maheen-ahmed1/27mhz-analog-walkie-talkie/BOM.csv

Order | Ref | Qty_per_unit | Qty_2_units | Design_Value | Part_To_Buy | Store | Unit_Price_BDT | Line_Total_BDT | Stock_checked_2026-09-21 | Link | Note
A | Q1,Q2 | 2 | 10 | BC547 | BC547 NPN Transistor | TechShopBD | 5.04 | 50.40 | In stock | https://techshopbd.com/product/bc547-npn-transistor | 4 needed; buy 10 - test every one (fakes will not oscillate at 27 MHz) and 1 for the crystal test jig
A | U1 | 1 | 2 | LM386 | LM386 OPAMP | TechShopBD | 20.05 | 40.10 | In stock | https://techshopbd.com/product/lm386-opamp | Also RobotechShop at same price
A | MK1 | 1 | 2 | Electret | Electret Microphone | TechShopBD | 20.04 | 40.08 | In stock | https://techshopbd.com/product/electret-microphone | Twist the lead pair (BUILD.md sec.6.6)
A | R1,R5 | 2 | 4 | 33k | 33K Ohm 1/4W Resistor Pack of 20 | TechShopBD | 10.04 | 10.04 | In stock | https://techshopbd.com/product/33k-ohm-14w-resistor-pack-of-20-1 | Slug without -1 is 3.3K - wrong part. Pack also supplies quench R1/R2 and test-jig bias
A | R2,R6 | 2 | 4 | 15k | 15K Ohm 1/4W Resistor Pack of 20 | TechShopBD | 10.04 | 10.04 | In stock | https://techshopbd.com/product/15k-ohm-14w-resistor-pack-of-20-1 | Slug without -1 is 1.5K - wrong part. Pack also supplies test-jig bias
A | R3,R7 | 2 | 4 | 56R | 56 Ohm 1/4W Resistor Pack of 20 | TechShopBD | 9.99 | 9.99 | In stock | https://techshopbd.com/product/56-ohm-14w-resistor-pack-of-20 | 56R IS CORRECT - never lower it (below ~30R the TX stops; on RX it does nothing)
A | R4,R8 | 2 | 4 | 390R | 390 Ohm 1/4W Resistor Pack of 20 | TechShopBD | 10.39 | 10.39 | In stock | https://techshopbd.com/product/390-ohm-14w-resistor-pack-of-20
A | R9 | 1 | 2 | 10k | 10K Ohm 1/4W Resistor Pack of 20 | TechShopBD | 10.04 | 10.04 | In stock | https://techshopbd.com/product/10k-ohm-14w-resistor-pack-of-20 | Sets 3.4 kHz quench filter with C11
A | R10 | 1 | 2 | 4k7 | 4.7K Ohm 1/4W Resistor Pack of 20 | TechShopBD | 15.07 | 15.07 | In stock | https://techshopbd.com/product/47k-ohm-14w-resistor-pack-of-20 | Electret bias
A | R11 | 1 | 2 | 10R | 10 Ohm 1/4W Resistor Pack of 20 | TechShopBD | 10.30 | 10.30 | In stock | https://techshopbd.com/product/10-ohm-14w-resistor-pack-of-20 | LM386 Zobel with C18
A | C5,C10 | 2 | 4 | 15p | Ceramic Capacitor 15pF 150 | TechShopBD | 1.09 | 4.36 | In stock | https://techshopbd.com/product/ceramic-capacitor-150-15pf | EXACT VALUE - do not substitute
A | C2,C7 + jig | 2 | 6 | 33p | Ceramic Capacitor 30pF 300 (SUBSTITUTE) | TechShopBD | 1.99 | 11.94 | In stock | https://techshopbd.com/product/ceramic-capacitor-300-30pf | 4 for C2/C7 + 2 for the crystal test jig. C2 is CRITICAL: measure and select - err LOW never high (+30% kills the TX)
A | C3,C8 + jig | 2 | 5 | 82p | Ceramic Capacitor 100pF 101 (SUBSTITUTE) | TechShopBD | 1.50 | 7.50 | In stock | https://techshopbd.com/product/ceramic-capacitor-101-100pf | 4 for C3/C8 + 1 test-jig output cap. 30p/100p substitute build VERIFIED in LTspice - slightly stronger than 33p/82p
A | C4,C9 + quench | 2 | 6 | 10n | Ceramic Capacitor 10nF 103 | TechShopBD | 1.50 | 9.00 | In stock | https://techshopbd.com/product/ceramic-capacitor-103-10nf | 4 emitter bypass (sit physically at the emitter) + 2 for 555 pin 5
A | C1,C6,C18 | 3 | 7 | 39n/47n | BUY 33nF (marked 333) - replaces BOTH the 39nF and the 47nF, which are not stocked | TechShopBD | 1.20 | 8.40 | In stock | https://techshopbd.com/product/ceramic-capacitor-333-33nf | C6 (RX) must stay 22-39nF: 33n gives 1.44x response vs 1.06x at 47n and deaf at 100n (sim, with quench). C1 (TX) and C18 (Zobel) are not sensitive
A | C11 | 1 | 2 | 4n7 | 0.0047uF 100V Capacitor | TechShopBD | 2.50 | 5.00 | In stock | https://techshopbd.com/product/00047uf-100v-capacitor | EXACT VALUE - sets quench low-pass
A | C19 | 1 | 2 | 100n | Ceramic Capacitor 100nF 104 | TechShopBD | 1.50 | 3.00 | In stock | https://techshopbd.com/product/ceramic-capacitor-104-100nf | Supply decoupling
A | C12,C13 | 2 | 4 | 0.47u/1u | 1uF 50V Capacitor | TechShopBD | 1.54 | 6.16 | In stock | https://techshopbd.com/product/1uf-50v-capacitor | 0.47u is out of stock; 1u for C12 improves HPF 34Hz to 16Hz
A | C14,C15 | 2 | 4 | 10u | 10uF 25V Capacitor | TechShopBD | 2.50 | 10.00 | In stock | https://techshopbd.com/product/10uf-25v-capacitor | Measure - market electrolytics run under value
A | C16,C20 | 2 | 4 | 100u | 100uF 16V Capacitor | TechShopBD | 3.02 | 12.08 | In stock | https://techshopbd.com/product/100uf-16v-capacitor | Supply reservoir
A | C17 | 1 | 2 | 220u | 220uF 16V Capacitor | TechShopBD | 5.02 | 10.04 | In stock | https://techshopbd.com/product/220uf-16v-capacitor | Speaker output coupling
A | RV1 | 1 | 2 | 10k log | 10k Potentiometer | TechShopBD | 20.05 | 40.10 | In stock | https://techshopbd.com/product/10k-potentiometer | Linear taper - acceptable for volume
A | SW1 | 1 | 2 | Power SPST | SPDT Slide Switch 0.34in | TechShopBD | 5.03 | 10.06 | In stock | https://techshopbd.com/product/spdt-slide-switch-034in | Use one throw as SPST
A | BT1 | 1 | 2 | 9V | 9V Battery | TechShopBD | 65.04 | 130.08 | In stock | https://techshopbd.com/product/9v-battery
A | BT1 | 1 | 2 | 9V clip | 9V Battery Connector | TechShopBD | 10.04 | 20.08 | In stock | https://techshopbd.com/product/9v-battery-connector | Buy a spare
A | - | 1 | 2 | Board | Veroboard Single Sided Line Type 14.5 x 6.5 cm | TechShopBD | 35.04 | 70.08 | In stock | https://techshopbd.com/product/veroboard-single-sided-line-type | LINE type (strips) not DOT type
A | QUENCH D1 | 1 | 2 | 1N4148 | Diode 1N4148 | TechShopBD | 1.50 | 3.00 | In stock | https://techshopbd.com/product/diode-1n4148 | QUENCH MOD - across 555 R2 to force 50% duty. REQUIRED: 67% duty is deaf (1.04x vs 1.90x response)
A | QUENCH C1 | 1 | 2 | 680p | Ceramic Capacitor 560pF 561 | TechShopBD | 1.09 | 2.18 | In stock | https://techshopbd.com/product/ceramic-capacitor-561-560pf | QUENCH MOD - 680p is OUT OF STOCK; fit 560p in PARALLEL with 120p = 680p = 32 kHz (verified value). 560p alone = 39 kHz
A | QUENCH C1 | 1 | 2 | 680p | Ceramic Capacitor 120pF 121 | TechShopBD | 1.00 | 2.00 | In stock | https://techshopbd.com/product/ceramic-capacitor-121-120pf | QUENCH MOD - parallel with the 560p above
A | QUENCH C1 alt | 1 | 2 | 470p | Ceramic Capacitor 471 470pF | TechShopBD | 1.09 | 2.18 | In stock | https://techshopbd.com/product/ceramic-capacitor-471-470pf | QUENCH MOD - bench-tuning option: 46 kHz
A | QUENCH C1 alt | 1 | 2 | 1n | Ceramic Capacitor 102 1000pF | TechShopBD | 2.04 | 4.08 | In stock | https://techshopbd.com/product/ceramic-capacitor-102-1000pf | QUENCH MOD - bench-tuning option: 22 kHz (looked weakest in sim)
A | JIG Re | 1 | 1 | 1k | 1K Ohm 1/4W Resistor Pack of 20 | TechShopBD | 10.04 | 10.04 | In stock | https://techshopbd.com/product/1k-ohm-14w-resistor-pack-of-20 | CRYSTAL TEST JIG emitter resistor (BUILD.md sec.6.2)
B | CV1 | 1 | 4 | 5-30p | Adjustable RF Trimmer Capacitor - choose 40pF | RobotechShop | 20.00 | 80.00 | In stock (40pF variant) | https://robotechshop.com/shop/components/capacitors/adjustable-trimmer-capacitor-variable-ceramic-capacitor-pcb-mount-for-rf-tuning/ | The 4-27pF trimmer (Tk10) went OUT OF STOCK. 40pF covers the 12-30pF netting range; 20pF variant only reaches mid-range. 2 + 2 spare
B | QUENCH U | 1 | 2 | NE555 | Timer IC 555 | RobotechShop | 15.00 | 30.00 | In stock | https://robotechshop.com/shop/components/general-ics/timer-ic-555/ | QUENCH MOD - QUENCH_MOD.md
B | sockets | 2 | 4 | DIP-8 | IC Base Socket - choose 14 Pin | RobotechShop | 8.00 | 32.00 | In stock (14-pin variant) | https://robotechshop.com/shop/components/ic-base-sockets-dip-sockets/ | 8-pin variant is OUT OF STOCK - cut 14-pin down to 8 with side cutters. For LM386 x2 and NE555 x2
D | Y1 | 1 | 2 | 27 MHz | 27 MHZ Crystal (Model# 3067) | Electronics.com.bd | 18.00 | 36.00 | In stock | https://electronics.com.bd/27-mhz-crystal-oscillators | 2-PIN passive crystal (CL 20pF +/-20ppm) - check pin count on arrival. Buy both in ONE order. 27.145 MHz version is stock out. Confirm fundamental (not 9 MHz overtone) with the test jig
C | SW2,SW3 | 1 | 2 | 4PDT PTT | 4PDT momentary push-to-talk switch | Nawabpur / Stadium Market | 75 | 150 | Not online |  | Nothing online is 4PDT momentary
C | LS1 | 1 | 2 | 8R | 8 Ohm 0.5-1W speaker 50-57mm | Nawabpur / Stadium Market | 45 | 90 | Not online |  | Both TechShopBD speakers OOS; RobotechShop has only 32R and 4R
C | ANT1 | 1 | 2 | Whip | Telescopic whip antenna ~1m | Nawabpur / Stadium Market | 150 | 300 | Not online |  | Range-test on 2.76m wire first (BUILD.md sec.6.9)
C | L1,L2 | - | - | 9T/2T | 0.5mm enamelled copper wire | Nawabpur / Stadium Market | 75 | 75 | Not online |  | TARGETS: L1 = 1.05-1.10 uH L2 = 1.14 uH (different on purpose). Wind one turn long and spread - adjusting turns recovers 87% from a 30% cap error
