maheen-ahmed1/27mhz-analog-walkie-talkie/out/wt27_BLOCKS.pdf

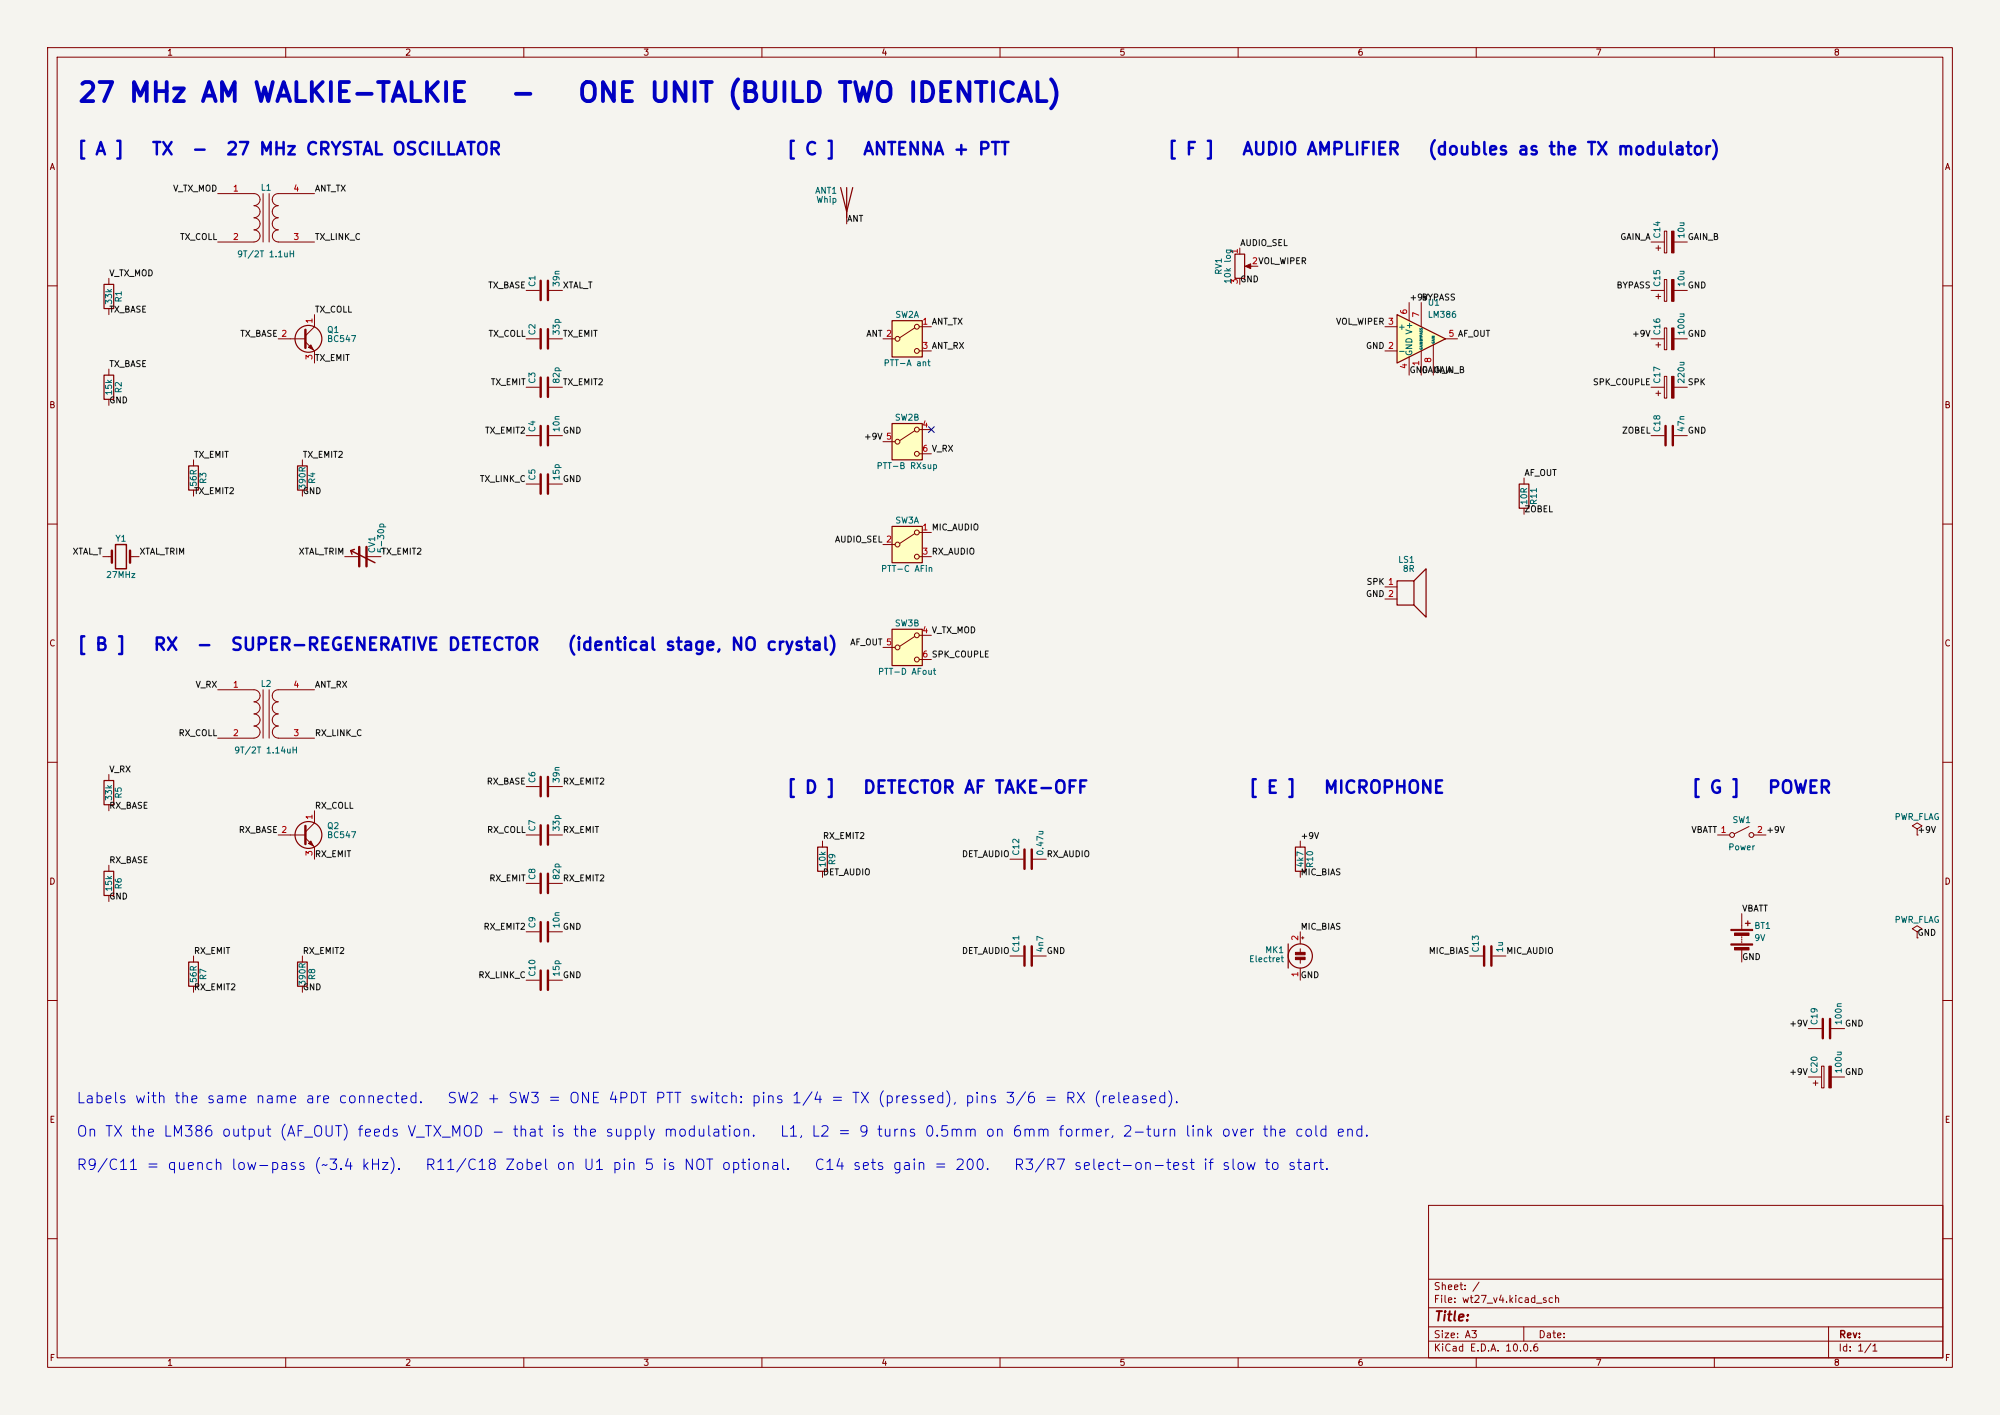
[picture p5: page 1]

Size: A3 | Rev: | F Date:
KiCad E.D.A. 10.0.6 | Id: 1/1
