maheen-ahmed1/27mhz-analog-walkie-talkie/out/wt27_WIRED.pdf

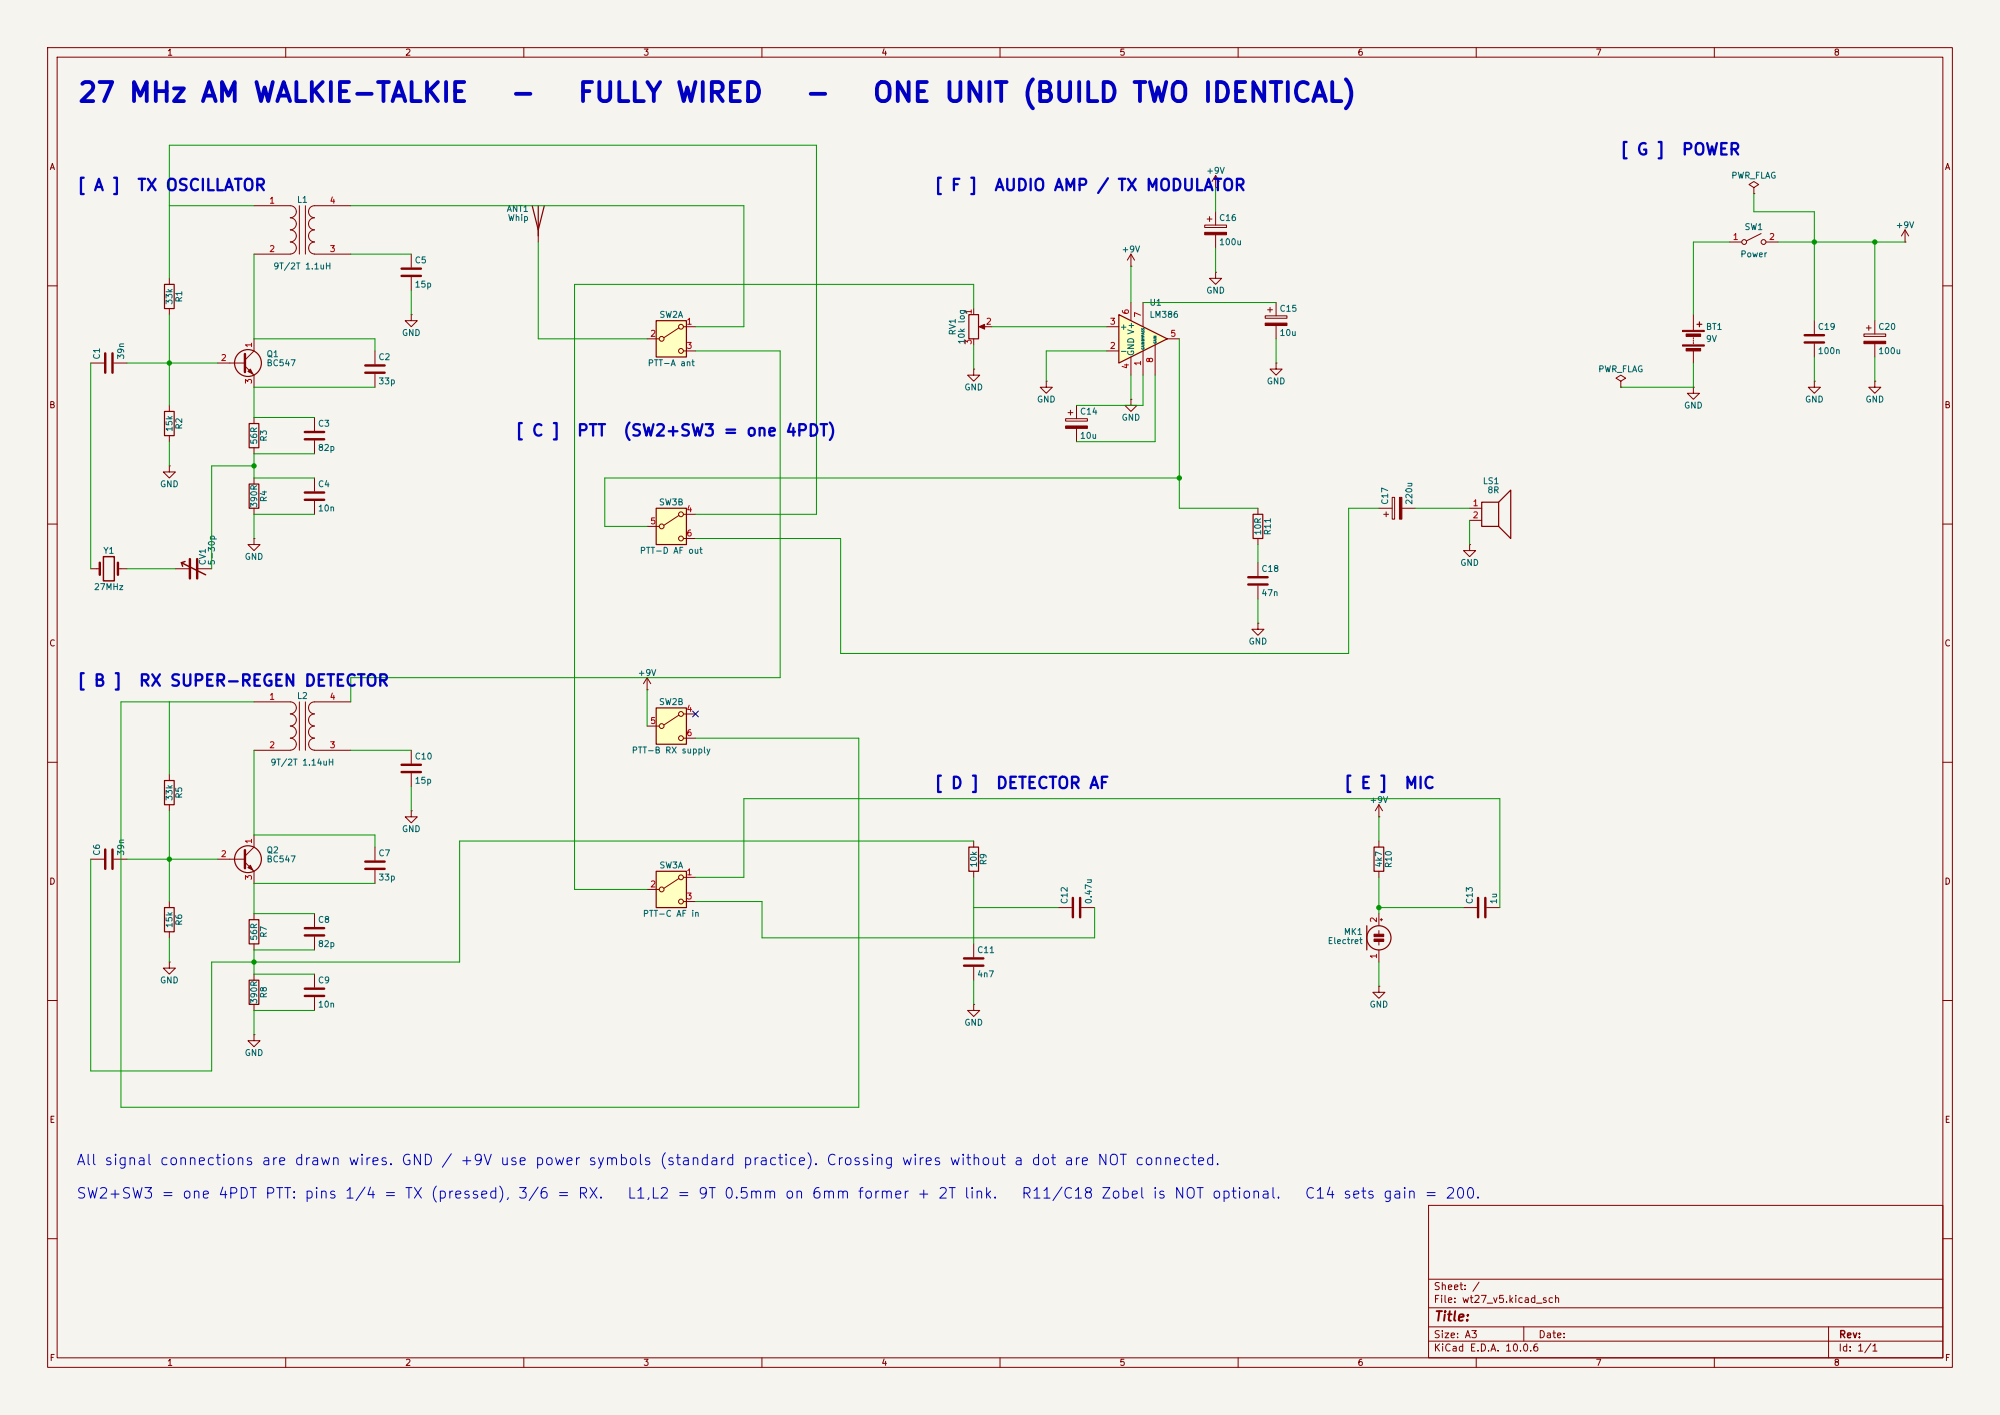
[picture p6: page 1]

[ F ] AUDIO AMP / TX MODULATOR

[ B ] RX SUPER-REGEN DETECTOR

All signal connections are drawn wires. GND / +9V use power symbols (standard practice). Crossing wires without a dot are NOT connected.

Size: A3 | Rev: | F Date:
KiCad E.D.A. 10.0.6 | Id: 1/1
