maheen-ahmed1/27mhz-analog-walkie-talkie/wt27_v5.kicad_sch

## KiCad design wt27_v5.kicad_sch (2026-10-22)

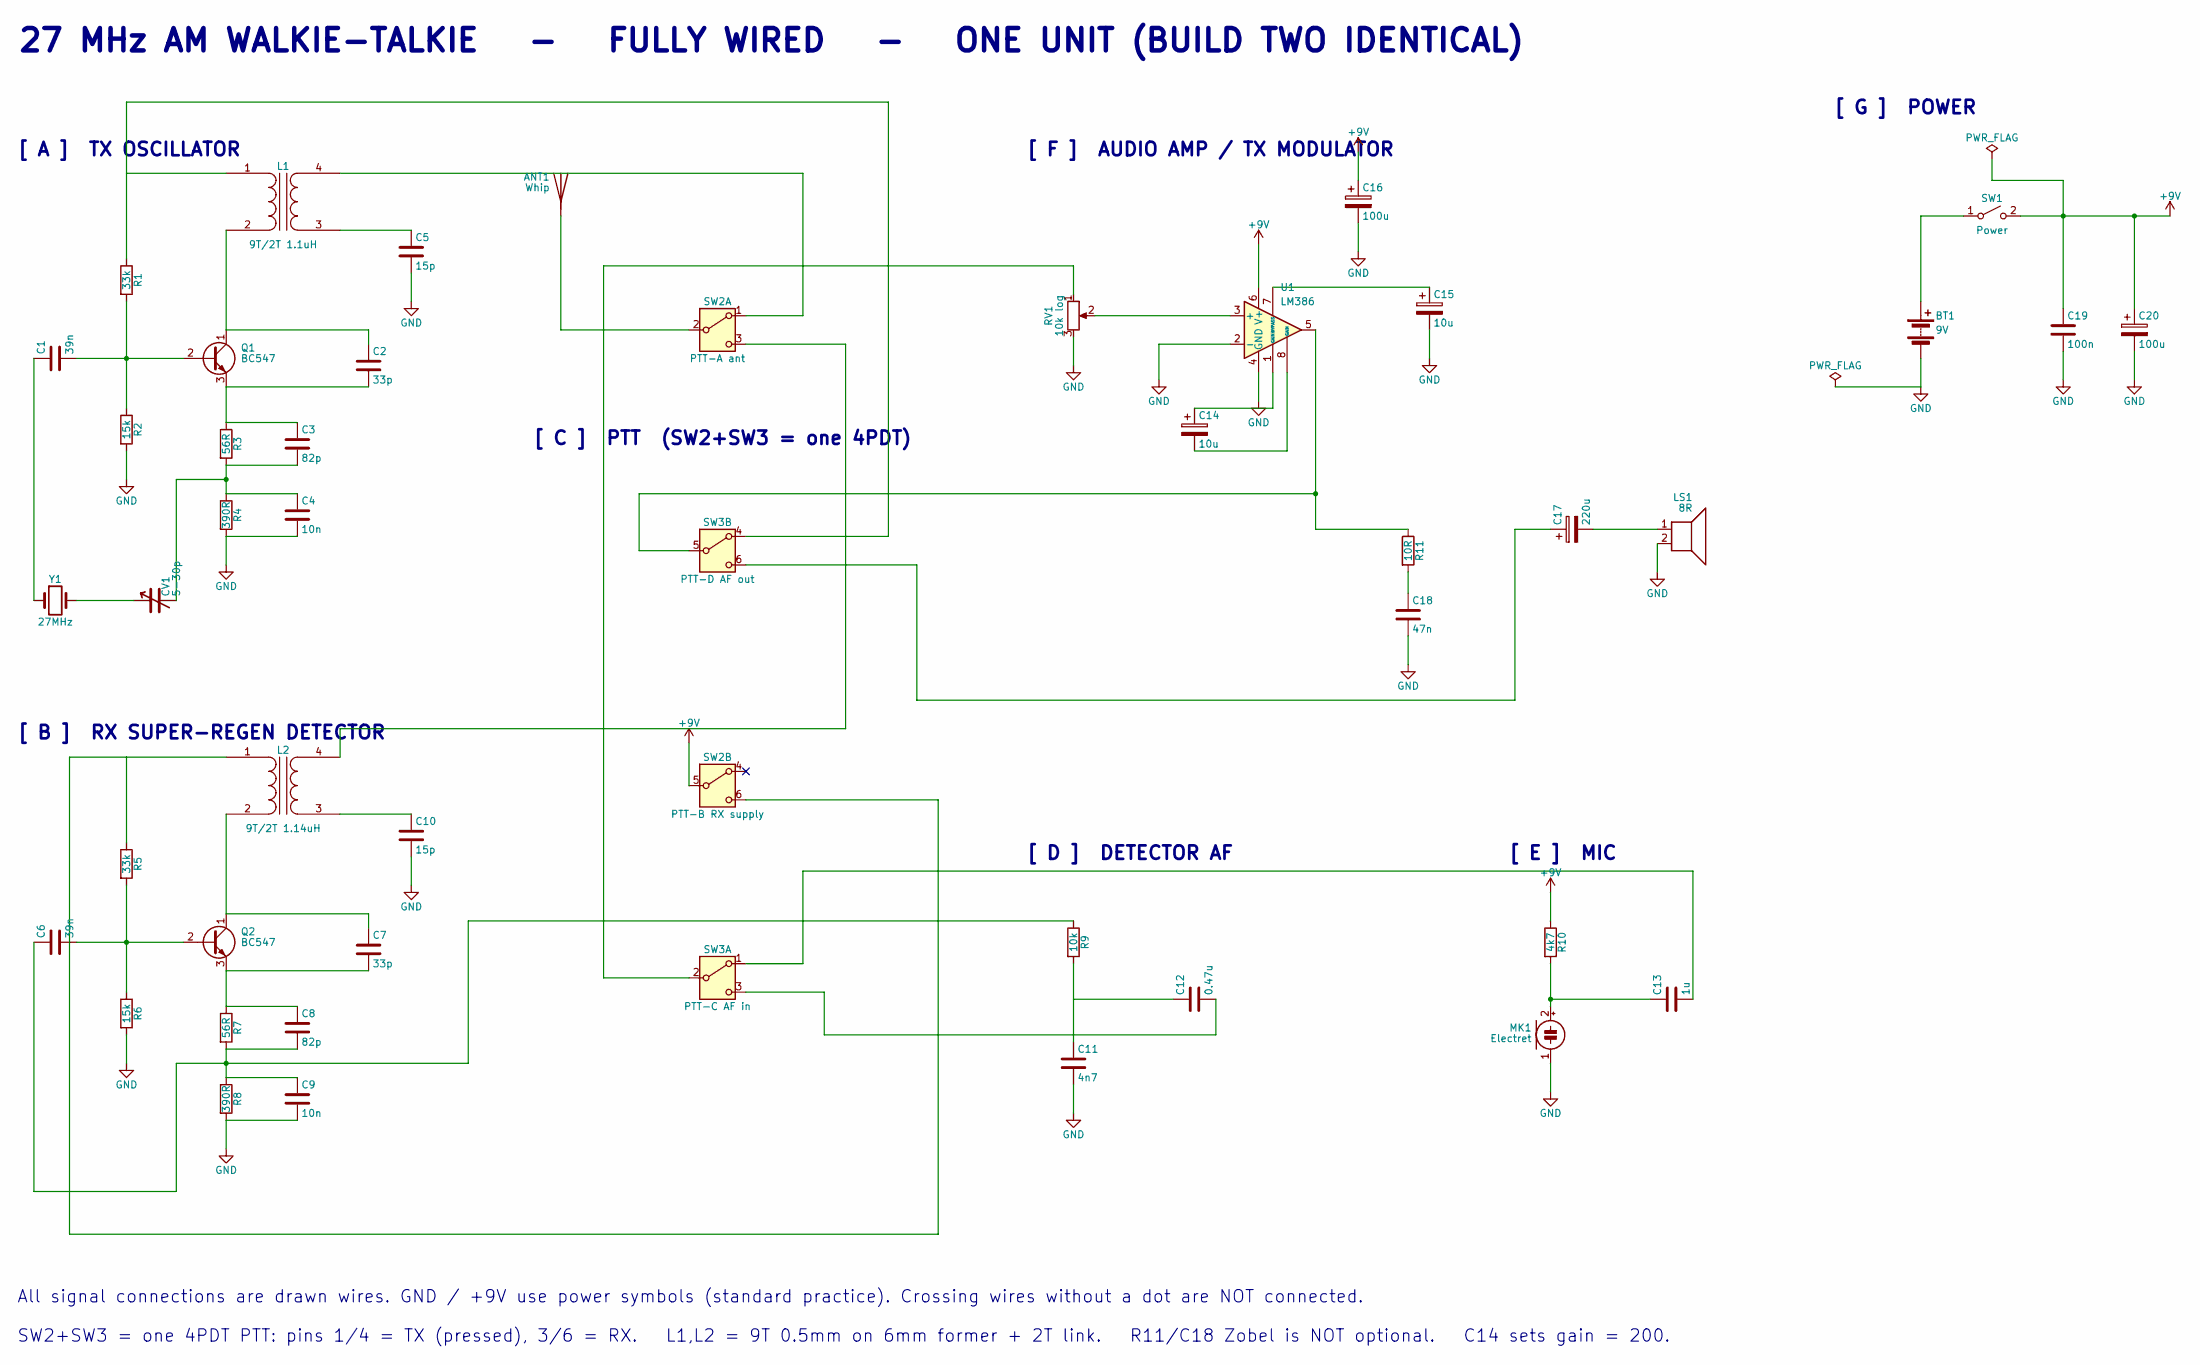
[picture p7: schematic wt27_v5.kicad_sch]

Parts:
ANT1: Whip
BT1: 9V
C1, C6: 39n
C2, C7: 33p
C3, C8: 82p
C4, C9: 10n
C5, C10: 15p
C11: 4n7
C12: 0.47u
C13: 1u
C14, C15: 10u
C16, C20: 100u
C17: 220u
C18: 47n
C19: 100n
CV1: 5-30p
L1: 9T/2T 1.1uH
L2: 9T/2T 1.14uH
LS1: 8R
MK1: Electret
Q1, Q2: BC547
R1, R5: 33k
R2, R6: 15k
R3, R7: 56R
R4, R8: 390R
R9: 10k
R10: 4k7
R11: 10R
RV1: 10k log
SW1: Power
SW2: PTT-A ant
SW3: PTT-D AF out
U1: LM386
Y1: 27MHz

Connections:
+9V: C16.1, C19.1, C20.1, R10.1, SW1.2 (B), SW2.5 (B), U1.6 (V+)
GND: BT1.2 (-), C4.2, C5.2, C9.2, C10.2, C11.2, C15.2, C16.2, C18.2, C19.2, C20.2, LS1.2, MK1.1 (-), R2.2, R4.2, R6.2, R8.2, RV1.3, U1.2 (-), U1.4 (GND)
unnamed: ANT1.1, SW2.2 (B)
unnamed: BT1.1 (+), SW1.1 (A)
unnamed: C1.1, Y1.1
unnamed: C1.2, Q1.2 (B), R1.2, R2.1
unnamed: C2.1, L1.2 (AB), Q1.1 (C)
unnamed: C2.2, C3.1, Q1.3 (E), R3.1
unnamed: C3.2, C4.1, CV1.2, R3.2, R4.1
unnamed: C5.1, L1.3 (SA)
unnamed: C6.1, C8.2, C9.1, R7.2, R8.1, R9.1
unnamed: C6.2, Q2.2 (B), R5.2, R6.1
unnamed: C7.1, L2.2 (AB), Q2.1 (C)
unnamed: C7.2, C8.1, Q2.3 (E), R7.1
unnamed: C10.1, L2.3 (SA)
unnamed: C11.1, C12.1, R9.2
unnamed: C12.2, SW3.3 (C)
unnamed: C13.1, MK1.2 (+), R10.2
unnamed: C13.2, SW3.1 (A)
unnamed: C14.1, U1.1 (GAIN)
unnamed: C14.2, U1.8 (GAIN)
unnamed: C15.1, U1.7 (BYPASS)
unnamed: C17.1, SW3.6 (C)
unnamed: C17.2, LS1.1
unnamed: C18.1, R11.2
unnamed: CV1.1, Y1.2
unnamed: L1.1 (AA), R1.1, SW3.4 (A)
unnamed: L1.4 (SB), SW2.1 (A)
unnamed: L2.1 (AA), R5.1, SW2.6 (C)
unnamed: L2.4 (SB), SW2.3 (C)
unnamed: R11.1, SW3.5 (B), U1.5
unnamed: RV1.1, SW3.2 (B)
unnamed: RV1.2, U1.3 (+)

Notes on the sheet:
27 MHz AM WALKIE-TALKIE - FULLY WIRED - ONE UNIT (BUILD TWO IDENTICAL)
[ A ] TX OSCILLATOR
[ B ] RX SUPER-REGEN DETECTOR
[ C ] PTT (SW2+SW3 = one 4PDT)
[ F ] AUDIO AMP / TX MODULATOR
[ G ] POWER
[ D ] DETECTOR AF
[ E ] MIC
All signal connections are drawn wires. GND / +9V use power symbols (standard practice). Crossing wires without a dot are NOT connected.
SW2+SW3 = one 4PDT PTT: pins 1/4 = TX (pressed), 3/6 = RX. L1,L2 = 9T 0.5mm on 6mm former + 2T link. R11/C18 Zobel is NOT optional. C14 sets gain = 200.
